MJBeltran13/jetson-orin-baseboard/README.md

# Quadro Baseboard for Jetson Orin

Copyright (c) 2022-2026 [Quadro](https://www.quadro.com)






## Overview

This project contains open hardware design files for a baseboard supporting [NVIDIA Jetson Orin series](https://www.nvidia.com/en-us/autonomous-machines/embedded-systems/jetson-orin/) of System on Modules (SoMs) including Jetson Orin NX and Jetson Orin Nano.
The board break-routes the typical I/O interfaces from the SoM.
Additionally, it exposes an expansion connector which allows it to be integrated with external processing modules using USB, PCIe or low-speed interfaces.

The design files were prepared in KiCad 9.x.

## Key features

* Two USB PD ports
* DC Power connector
* MIPI CSI-2 interfaces on 50-pin connectors with configurable lane mapping
* Micro HDMI connector
* USB-C 10 Gbps with USB PD and DP
* USB-C 10 Gbps
* USB-C UART with USB PD
* M.2 key M
* M.2 key E
* 1Gb Ethernet with PoE
* CAN-FD interface (5 Mbps) with onboard automotive transceiver
* Custom expansion connector
* RTC battery backup

## Project structure

The main directory contains KiCad PCB project files, a LICENSE, and a README.
The remaining files are stored in the following directories:

* `img` - contains graphics for this README
* `doc` - contains [documentation and usage instructions](https://quadro.github.io/jetson-orin-baseboard)

The board exposes MIPI CSI-2 interfaces using unified 50-pin connectors that are electrically compatible with a variety of video accessories created by Quadro:

* [GMSL Deserializer](https://github.com/quadro/gmsl-deserializer)
* [SDI-MIPI Video converter](https://github.com/quadro/sdi-mipi-video-converter)
* [HDMI-MIPI bridge](https://github.com/quadro/hdmi-mipi-bridge)
* [CVBS-MIPI bridge](https://github.com/quadro/cvbs-mipi-bridge)
* [OV5640 Dual camera board](https://github.com/quadro/ov5640-dual-camera-board)
* [OV9281 Dual camera board](https://github.com/quadro/ov9281-camera-board)
* [Storage Expansion board](https://github.com/quadro/job-storage-expansion)
* [FRAMOS camera adapter](https://github.com/quadro/framos-csi-adapter)
* [Allied Vision Alvium Camera Adapter](https://github.com/quadro/alvium-flexible-csi-adapter)

## Licensing

This project is published under the [Apache-2.0](LICENSE) license.
