MJBeltran13/jetson-orin-baseboard/output/feasibility/Quadro_1_Year_Precommercialization_Proposal.docx

| Reference No.: BatStateU-FO-RES-02 | | Effectivity Date: August 22, 2023 | | Revision No.: 04

DETAILED RESEARCH PROPOSAL

I. Research Project Title: Pre-Commercialization Development and Validation of Quadro Hardware and a Custom Linux OS for AI and Linux Learning (12 Months)

II. BatStateU Research Agenda: Industry, Energy and Emerging Technology Research (IEETR)

III. Sustainable Development Goal:
☐ SDG1: No Poverty | | | | ☐ SDG10: Reduced Inequalities
☐ SDG2: Zero Hunger | | | | ☐ SDG11: Sustainable Cities & Communities
☐ SDG3: Good Health & Well-being | | | | ☐ SDG12: Responsible Consumption & Production
☐ SDG4: Quality Education | | | | ☐ SDG13: Climate Action
☐ SDG5: Gender Equality | | | | ☐ SDG14: Life Below Water
☐ SDG6: Clean Water & Sanitation | | | | ☐ SDG15: Life on Land
☐ SDG7: Affordable and Clean Energy | | | | ☐ SDG16: Peace, Justice, & Strong Institutions
☐ SDG8: Decent Work & Economic Growth | | | | ☐ SDG17: Partnerships for the Goals
☐ SDG9: Industry, Innovation, & Infrastructure

IV. Project Leader: ____________________________________

Email Address: ____________________________________

Contact Number: ____________________________________

Project Staff: ____________________________________

Email Address: ____________________________________

V. Proponent Agency: Batangas State University

Department: STEER Hub

College: College of Engineering

Campus: Central

VI. Cooperating Agency: ____________________________________

Partner institutions will be identified through the pilot and market-validation activities.

VII. Executive Brief:

Quadro is a proposed educational computer combining a custom carrier board, a production NVIDIA Jetson Orin Nano 8 GB module and Quadro Learning OS. The 12 month project will develop and validate a maintained Linux image, guided AI and Linux lessons, recovery tools and instructor materials for Philippine educational institutions.

The existing repository supplies carrier design files and a reference Yocto BSP. It also records unresolved repair and qualification work. The proposed learning OS and educational outcomes have not yet been validated; release depends on engineering tests, classroom pilots and verified customer budgets. [1][2][3]

The 12 month version focuses on 10 engineering kits, three research cohorts, at least 30 learners and 10 instructors, and a documented commercial readiness decision.

The provisional project expenditure is PHP 2,900,000, excluding commercial inventory and paid-workshop delivery. Funding sources and eligible cost categories remain subject to institutional review. Commercial forecasts are conditional scenarios, rather than research outputs or assured sales.

VIII. Rationale:

AI education benefits from opportunities to prepare data, run models, examine errors and deploy applications. Linux competence also requires practical work with files, permissions, packages, networking, services and recovery. A dedicated learning device can connect these activities within one reproducible environment, provided the hardware and lessons remain reliable and usable.

Quadro will initially serve college and technical training laboratories with a clear edge AI use case. Schools can use existing PCs for many introductory Linux activities; the project must therefore demonstrate the added value of GPU-assisted deployment, physical interfaces and a supported classroom image. Affordability and willingness to buy will be investigated rather than assumed.

The first configuration will include an Orin Nano 8 GB production module, Quadro carrier, 128 GB NVMe storage, suitable power, active cooling and an enclosure. Displays, keyboards, mice and optional cameras are outside the base kit. The learning image will expose the normal Linux terminal and administration tools while adding lessons, notebooks and a documented recovery process.

The repository reference uses Yocto and JetPack 6.1. An Ubuntu-based learner image is proposed, with a carrier-specific migration and test plan. NVIDIA lists Orin support in JetPack 7.2.1; that support does not establish compatibility with the current Quadro board. Device tree, boot configuration, flashing and peripheral checks are required. [2][5][6]

The project will produce one validated hardware configuration, one versioned learning image, a 40 hour introductory course with 12 practical labs, a learner workbook, a teacher guide and a commercial readiness package. A proprietary cloud service or new LMS is outside the initial scope. Software, models and teaching materials will be distributed only under applicable licences. [11]

IX. Objectives of the Project:

The general objective is to establish the technical, educational, operational and commercial feasibility of Quadro as an AI and Linux learning platform within 12 months.

Specifically, the project aims to:

1. Repair and qualify 10 engineering kits, closing release-blocking design and manufacturing issues before classroom deployment.

2. Develop and test a custom Linux learning image, secure account setup, recovery procedure, 40 hour course and 12 practical labs.

3. Conduct three research cohorts with at least 30 learners and 10 instructors, using pre/post skills assessments, observation and structured feedback.

4. Validate institutional requirements through 20 buyer interviews, supplier quotations, a priced bill of materials and pilot agreements.

5. Prepare a business model, supply-chain workflow, compliance plan and evidence-based decision on controlled commercialization by month 12.

X. Expected Output of the Project:

1. Ten (10) engineering kits with serialised qualification records, a released design revision and a priced bill of materials.

2. One (1) tested Quadro Learning OS image, installation and recovery package, release manifest and account-security guide.

3. One (1) 40 hour course with twelve (12) labs, a learner workbook and a teacher reference guide covering Linux foundations, administration, Python, AI inference and a final project.

4. Three (3) research pilot cohorts, at least thirty (30) learner participants and ten (10) instructor participants.

5. One (1) iteration report after each cohort, with assessment summaries, usability findings, support effort and resulting changes.

6. One (1) business model, cost and price table, supply-chain map, support plan, compliance checklist and commercial release roadmap.

7. At least two (2) written pilot agreements and two (2) potential institutional or distribution channels investigated. No signed commercial partnership is assumed.

8. One (1) final technical and educational validation report and one (1) manuscript prepared for submission. Publication acceptance is outside the project team's control.

Proposed educational success criteria
Target at least 80 percent core-lab completion, 70 percent final-project completion and a median 20 percentage point improvement on the same skills rubric. Record unsuccessful attempts and withdrawals. These are proposed targets, not measured outcomes.

Social and economic impact
The intended social benefit is improved access to practical AI deployment and Linux skills through reusable teaching materials and locally supported equipment. The intended economic benefit is a tested route to assembly, training and support services. Adoption, employment and spin-off formation are possible outcomes to assess, rather than guaranteed impacts.

XI. Review of Related Literature:

1. What Has Been Done
Freeman et al. analysed 225 undergraduate STEM studies and reported better performance under active learning than traditional lecturing. This supports guided practice, problem solving and feedback in the proposed course. The study does not isolate ownership of a device or establish the effectiveness of Quadro, Linux instruction or AI training. [8]

Ouyang and Xu examined educational robotics across STEM settings and reported a positive overall effect, with variation across outcomes. Robotics differs from Quadro's AI and Linux focus. Their results support investigating a physical learning platform together with instructional design; they do not justify attributing gains to hardware alone. [9]

2. What Is Currently Being Done
NVIDIA provides Jetson educational resources and an ecosystem for hands-on AI projects. Its current Jetson software includes Orin support, while custom carrier deployment still requires adaptation and validation. These resources establish an available technical foundation rather than evidence of Quadro classroom success. [5][6][7]

The Linux Foundation's introductory course covers graphical and command-line work, applications and system configuration. It provides a curriculum benchmark and an optional learner resource. Free access does not establish permission to copy the course into Quadro materials. [10]

3. What We Are Proposing
Quadro will combine a qualified carrier board, a maintained learning image and assessed Linux and AI activities. Its contribution to investigate is whether this combination reduces teacher setup effort and supports completion of practical tasks in local classrooms. The study will document setup time, recovery effort, completion, assessed skill change and support demand.

The pilot will use pre/post assessment and qualitative feedback. Without random assignment or a comparison group, the results will support feasibility and iteration decisions, rather than a causal claim that Quadro outperforms other teaching methods. Local purchase demand and cost will be tested separately.

XII. Methodology:

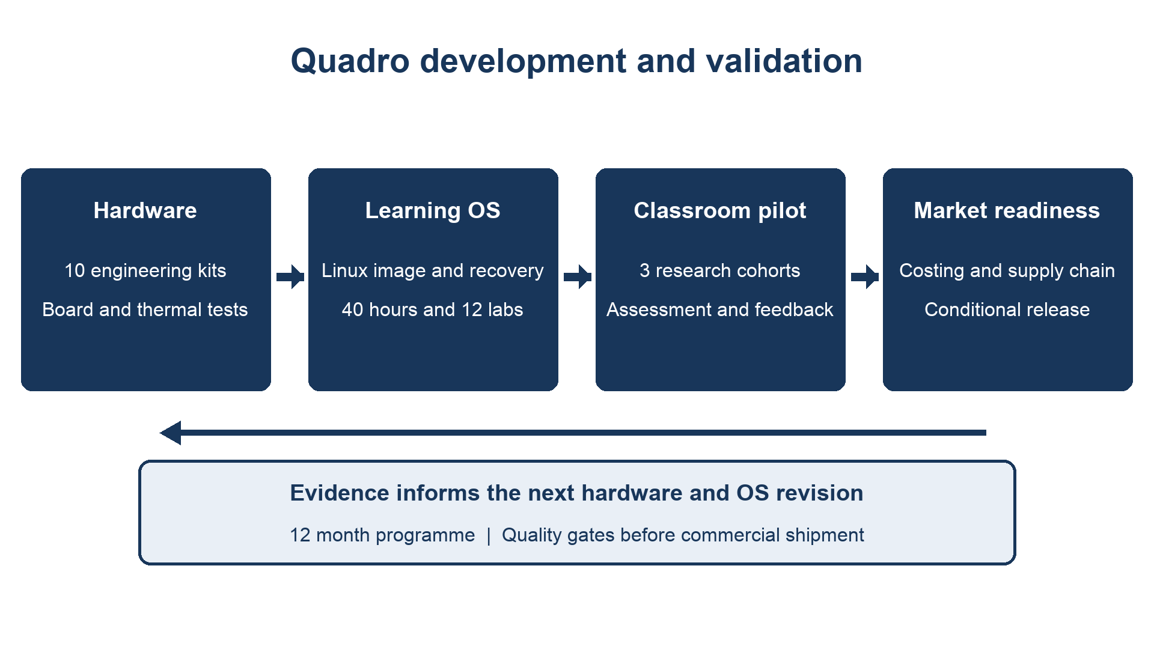
[picture p1: figure]
Quadro hardware, learning OS, classroom validation and commercial readiness process

Phase I Platform and demand definition Months 1 to 3
Interview 10 instructors, five lab managers and five procurement or budget staff. Record target learners, existing facilities, intended AI use cases, acceptable total cost and purchasing dates. Seek two pilot agreements without describing interest as a sale.

Review the current repair plan, complete a costed BOM and obtain assembly and landed-module quotations. Select one hardware revision and learner OS baseline. Demonstrate desktop operation, GPU libraries, storage, Ethernet and recovery on the target board by month 3 or revise the schedule. [3][6]

Phase II Engineering and learning package Months 3 to 6
Build and qualify 10 engineering kits. Proposed tests include 20 cold boots per kit and an eight hour mixed CPU, GPU and storage workload without a crash or thermal shutdown. Resolve release blockers, check accessible interfaces and record test conditions. These tests supplement, rather than replace, safety and compliance review.

Develop the learning image, first-boot credentials, student accounts, lesson launcher, Python notebooks and recovery instructions. Create 12 labs across Linux foundations, administration, AI inference and a small transfer-learning exercise. Large-model training is outside the introductory scope. Validate every included AI model on the final image.

Phase III Research pilots and revision Months 5 to 12
Conduct three cohorts with at least 30 learners and 10 instructors in total. Record voluntary participation, obtain required institutional and ethics permissions, and use anonymised identifiers. Educational participation will not depend on consenting to research data collection.

Use the same task rubric before and after instruction. Collect completion records, teacher setup time, recovery effort, support tickets, surveys and focused discussions. Analyse scores, paired changes, completion rates and qualitative themes descriptively; report sample size, withdrawals and limitations. Keep personal data access restricted and follow institutional retention rules.

Prepare an iteration report after each cohort. Re-test affected hardware or OS functions before further use. Research cohorts use engineering kits; paid customer workshops and saleable kits are separate enterprise activities and are not charged again to the pilot budget.

Commercial feasibility and release decisions
Use a proposed net kit price of PHP 49,000 and an illustrative 12 percent VAT-inclusive price of PHP 54,880 for willingness-to-pay testing. All price, volume, exchange and cost values remain assumptions until supported by quotations and orders. Production modules, rather than development kits, underpin the saleable product. [4]

The conditional enterprise scenario is 100 kits and six paid workshops in year 1. It produces a PHP 1.310 million result loss before tax, depreciation and financing.

Do not commit to the first 50 saleable kits until qualified prototypes, written manufacturing acceptance, a costed BOM at or below PHP 36,000 per kit, and at least 30 units of funded orders are in place. Confirm product-specific safety, EMC, radio, licence and data requirements before public sale. Each commercial unit requires a documented functional test.

XIII. Duties and Responsibilities of Each Member:

Project Leader and Project Operations
Coordinate deliverables, budget, research permissions, partner discussions and release decisions. Maintain the risk register and distinguish research funding from enterprise cash. Review prototype evidence, cohort findings and procurement commitments before authorising each stage.

Linux and BSP Engineer
Adapt the carrier configuration, build and version the learning image, maintain GPU and package compatibility, implement account and update security, and test recovery. Keep reproducible build instructions and an inventory of software and model licences.

Hardware and Manufacturing Engineer
Close schematic, PCB and manufacturing release blockers; manage prototype spins, power and thermal checks, assembly instructions and serialised production tests. Obtain supplier quotations and document design and BOM changes.

Curriculum and Validation Specialist
Prepare the 40 hour course, 12 labs, learner workbook and teacher guide. Design the rubric, facilitate research cohorts, analyse results and document revisions. Ensure pilot participation and data handling follow institutional requirements.

Staffing and accountability
The budget uses fractional role allocations, not four confirmed full-time appointments. Named assignments, qualifications, employment terms and institutional approvals must be completed before engagement. Extra specialist work requires an approved budget revision.

XIV. Major Activities and Work Plan:

See included Form A for the 12 month quarterly work plan and evidence required to proceed.

XV. Line Item Budget:

See included Form B. Proposed project expenditure totals PHP 2,900,000. Funding-source allocation and eligible classifications require institutional and funder approval. Commercial inventory and paid-workshop delivery are excluded from this project-cost total.
Personnel Services provisional classification | | PHP 1,440,000
Maintenance and Operating Expenses | | PHP 1,260,000
Capital Outlay and Equipment | | PHP 200,000
Total Proposed Project Cost | | PHP 2,900,000

XVI. References:

[1] Quadro. Jetson Orin Baseboard README and Apache 2.0 licence. Repository README.md, lines 12 to 31 and 54 to 56; LICENSE, sections 4 and 6.

[2] Quadro. Getting started and reference BSP. Repository doc/source/getting_started.md, lines 12 to 60, 133 to 151 and 324 onward.

[3] Quadro. PCB Repair Implementation Plan. Repository doc/PCB_REPAIR_PLAN.md, baseline dated 14 October 2026 and release gates. This is a recorded baseline, not fresh qualification.

[4] NVIDIA. Jetson FAQ. Production module guidance and suggested volume pricing; accessed 20 October 2026. Source (https://developer.nvidia.com/embedded/faq)

[5] NVIDIA. JetPack 7.2.1 with Jetson Linux 39.2.1. Orin support and Ubuntu 24.04 baseline; accessed 20 October 2026. Source (https://developer.nvidia.com/embedded/jetpack/downloads/archive-7.2.1)

[6] NVIDIA. Jetson Orin NX and Nano Series Adaptation and Bring Up. Carrier configuration and custom root filesystems; accessed 20 October 2026. Source (https://docs.nvidia.com/jetson/archives/r39.2.1/DeveloperGuide/HR/JetsonModuleAdaptationAndBringUp/JetsonOrinNxNanoSeries.html)

[7] NVIDIA. Jetson AI Education. Curriculum and project resources; accessed 20 October 2026. Source (https://developer.nvidia.com/embedded/learn/jetson-ai-education)

[8] Freeman, S., Eddy, S. L., McDonough, M., Smith, M. K., Okoroafor, N., Jordt, H., and Wenderoth, M. P. (2014). Active learning increases student performance in science, engineering, and mathematics. PNAS, 111(23), 8410-8415. DOI 10.1073/pnas.1319030111. Source (https://doi.org/10.1073/pnas.1319030111)

[9] Ouyang, F., and Xu, W. (2024). The effects of educational robotics in STEM education: A multilevel meta-analysis. International Journal of STEM Education, 11, Article 7. DOI 10.1186/s40594-024-00469-4. Source (https://doi.org/10.1186/s40594-024-00469-4)

[10] The Linux Foundation. Introduction to Linux LFS101. Course description; accessed 20 October 2026. Source (https://training.linuxfoundation.org/training/introduction-to-linux/)

[11] NVIDIA. Jetson Linux 39.2.1 Software License Agreement. Redistribution conditions and component licence terms; accessed 20 October 2026. Source (https://developer.download.nvidia.com/embedded/L4T/r39_Release_v2.1/release/Tegra_Software_License_Agreement-Tegra-Linux.txt)

XVII. Curriculum Vitae: See included Form C completion sheet. Attach the signed CV of each designated researcher and specialist before formal submission.

*Required Attachment (use appropriate ISO Form): (A) Major Activities and Work Plan; (B) Line-item Budget; (C) Curriculum Vitae

Prepared by: ________________________________ ________________________________ Project Leader Date Signed: | | | | Department: STEER Hub
| | | | College: College of Engineering / Integrated School
| | | | Campus: Central

Pursuant to Republic Act No. 10173, also known as the Data Privacy Act of 2012, the Batangas State University, the National Engineering University recognizes its commitment to protect and respect the privacy of its customers and/or stakeholders and ensure that all information collected from them are all processed in accordance with the principles of transparency, legitimate purpose and proportionality mandated under the Data Privacy Act of 2012.

To be accomplished by the Research Office
Checklist: ☐ Complete Documents Detailed Proposal LIB Work Plan ☐ Initial Screening Form Score: _______ | | | | Level of Call ☐ Central Agency (VPRDES, President) ☐ Constituent Campus (VCRDES, Chancellor)

To be accomplished by the Researcher/s
Checked and Verified by: ____________________________ ________________________________ Director, Research Date Signed: | | | | Recommending Approval: ____________________________ ________________________________ Vice President for Development and Extension Services Date Signed:

Approved by the Research Council Represented by:

_______________________________

________________________________

University President/

Date Signed:

Notes: The Signatories funded by:

Approval through Research Council

Director, Research; Vice President for RDES: & University President

Approval through Local Research Evaluation Committee

Head, Research/Head Research & Extension; Vice Chancellor for RDES; & Vice President for RDES

| Reference No.: BatStateU-FO-RES-02 | | Effectivity Date: August 22, 2023 | | Revision No.: 04

FORM A MAJOR ACTIVITIES AND WORK PLAN

Project: Quadro Hardware and Custom Linux OS for AI and Linux Learning | Duration: 12 months

Each quarter covers three months from project commencement. X indicates planned activity; release depends on the evidence listed.

Activity | Q1 | Q2 | Q3 | Q4 | Output
Buyer interviews and pilot agreements | X | | | | 20 interviews and 2 pilot agreements
Carrier repair and engineering kits | X | X | | | 10 kits with qualification records
Learning OS build and recovery | X | X | X | X | Tested image and recovery package
Course workbook and teacher guide | X | X | X | X | 40 hours and 12 labs
First 3 research cohorts and revision | | X | X | X | 30 learners and 10 instructors
BOM costing and supply chain | X | X | X | X | Quotes cost model and manufacturing workflow
Commercial readiness assessment | | | X | X | Conditional launch decision

Responsibilities: Project Leader coordinates delivery and approvals; Linux Engineer owns the OS; Hardware Engineer owns board and manufacturing evidence; Curriculum Specialist owns learning materials and pilot assessment.

Gate 1 by month 3: demonstrate the target learner image and identify buyer budgets. Gate 2 by month 6: close release blockers and qualify prototypes. Gate 3 before commercial build: confirm compliance, costed BOM, manufacturing acceptance, funded orders and cash availability.

| Reference No.: BatStateU-FO-RES-02 | | Effectivity Date: August 22, 2023 | | Revision No.: 04

FORM B LINE ITEM BUDGET

Quadro 12 month project | Currency PHP | Provisional expenditure before final institutional classification

Budget line | Basis | Amount PHP
Linux and BSP engineering | 45,000 monthly x 12 | 540,000
Hardware and manufacturing engineering | 35,000 monthly x 12 | 420,000
Curriculum and validation | 25,000 monthly x 12 | 300,000
Project and customer operations | 15,000 monthly x 12 | 180,000
Personnel subtotal | Fractional role allocations | 1,440,000
Facilities administration sales and support | 30,000 monthly x 12 | 360,000
Engineering kits and board spins | 10 engineering kits and revision allowance | 480,000
OS release work | External work beyond team allocation | 100,000
Research pilot activities | Separate from paid workshops | 80,000
External validation and compliance | Scope and quotations to confirm | 140,000
Production setup and instructions | External setup allowance | 100,000
MOOE subtotal | Subject to eligibility review | 1,260,000
Test and recovery equipment | Equipment allowance | 200,000
Total proposed project expenditure | Excludes enterprise trading costs | 2,900,000

Personnel amounts are planning allocations; the institution will determine whether an item is personnel services or contracted services. Sales, warranty and enterprise support may require counterpart funding. No allowance is confirmed eligible for a grant. Final funding sources and counterpart shares remain for approval.

No double counting: the engineering kits and board spins are in development expenditure. Saleable kits are enterprise inventory. Paid customer-workshop delivery is separate from the research pilot allowance. Team labour is separate from the listed external work.

Separate commercial scenario: year 1 inventory purchases PHP 3,600,000 and paid-workshop variable costs PHP 60,000; these are outside the PHP 2,900,000 project-cost total.

The enterprise base case has PHP 5,050,000 revenue and a PHP 1,310,000 result loss before tax, depreciation and financing. Its conservative cash-funding envelope is PHP 6,810,000.

Cash envelopes include project and trading flows, no deposits, two-month hardware collections, prepaid batches and a 20 percent reserve on the cash trough. They are not grant budgets and must not be added to the project-cost total. Tax timing, bad debts and financing require a separate cash review.

All figures are estimates rather than quotations. The PHP 27,000 year 1 landed module target assumes PHP 60 per USD and additions to NVIDIA's USD 399 suggested 1000-unit price. Small-volume pricing must be quoted. [4]

| Reference No.: BatStateU-FO-RES-02 | | Effectivity Date: August 22, 2023 | | Revision No.: 04

FORM C CURRICULUM VITAE COMPLETION SHEET

Complete one signed institutional CV for each designated member. This sheet records the information required; it does not state credentials or confirm appointment.

Required information | To be completed by the named person
Full name | ____________________________________________
Proposed project role | ____________________________________________
Institution department and position | ____________________________________________
Email and contact number | ____________________________________________
Highest degree field institution and year | ____________________________________________ ____________________________________________
Relevant hardware Linux AI or teaching experience | ____________________________________________ ____________________________________________ ____________________________________________
Relevant projects and responsibilities | ____________________________________________ ____________________________________________ ____________________________________________
Selected publications or technical outputs | ____________________________________________ ____________________________________________
Professional registration or training if relevant | ____________________________________________ ____________________________________________
Proposed time allocation and availability | ____________________________________________
Signature and date | ____________________________________________

Attach supporting and signed CVs using the institution's current prescribed format before submission. Approval names, signatures and dates in the proposal remain blank until completed by the authorised individuals.

Tracking No.________________ Page of
