MJBeltran13/jetson-orin-baseboard/output/feasibility/Quadro_Feasibility_Study_1_Year_Philippines.docx

# Quadro feasibility study 1 year

Philippines | AI and Linux learning hardware

12 month pilot and launch plan | 20 October 2026

# Executive decision

Proceed with a funded pilot only. A 12 month programme can test Quadro hardware, its educational Linux image and school demand. The base case does not recover development or operating costs within the year. Commercial shipments depend on successful board qualification and funded orders.

Quadro is a proposed learning computer built around a custom carrier board and a production NVIDIA Jetson Orin Nano 8 GB module. Quadro Learning OS is the proposed name for a maintained Linux distribution with lessons, AI tools and recovery support. It is a product to develop, rather than an established educational OS.

Decision metric | Base case assumption
Planning horizon | 12 months
Hardware sales target | 100 kits
Price per kit excluding VAT | PHP 49,000
Illustrated price including 12 percent VAT | PHP 54,880
Revenue | PHP 5.050 million
Result before tax depreciation and financing | PHP 1.310 million loss
Planning funding envelope | PHP 6.810 million

All financial figures are scenario estimates, not supplier quotations or confirmed demand. The funding envelope includes a 20 percent reserve on the conservative cash trough. Tax cash timing and finance costs require an additional review.

## Evidence that changes the decision

The repository documents an existing Orin carrier design and a reference Yocto BSP. Its 14 October 2026 repair plan also records unresolved design and release work. Historical board releases do not qualify the current revision for classroom sale. Fresh engineering checks and bench evidence are required. [1][2][3]

This study treats months as time from funding approval. Year 1 is identical in both versions, allowing a direct comparison. The intended readers are Quadro founders, education partners and prospective funders.

# Product and technical feasibility

## A focused first product

Launch one configuration: Orin Nano 8 GB production module, Quadro carrier, 128 GB NVMe, suitable power supply, active cooling, protective enclosure and preinstalled learning image. Include a recovery guide, teacher notes and basic hardware support. Schools supply displays, keyboards, mice and network access. Cameras, robotics kits and Wi-Fi are optional and outside the base costing.

The README lists camera, USB, HDMI, M.2, Ethernet and expansion interfaces. Validate each interface included in the sale specification on the exact board revision. Do not promise every documented interface or a high power mode before testing. [1][3]

## Build the learning OS on supported Linux

The repository reference is a Yocto system based on JetPack 6.1. NVIDIA now lists JetPack 7.2.1 with Orin support and an Ubuntu 24.04 baseline. These are different software baselines; migration and carrier compatibility need explicit testing. [2][5]

Use an Ubuntu based Jetson image as the preferred learner environment. Reuse verified carrier configuration where compatible. NVIDIA requires carrier-specific device tree, boot configuration and flashing work. By month 3, demonstrate the desktop, GPU libraries, storage, Ethernet and recovery on the target board; otherwise replan the launch. A Yocto reference image remains useful for hardware diagnosis. [6]

Add Quadro lesson packages, a desktop lesson launcher, Python notebooks and reproducible environments. Keep the terminal and normal Linux administration tools available. Use standard package and image tooling. Provide unique first-boot credentials, student accounts, signed release manifests, tested updates and a documented reflash procedure.

## Learning scope and evidence

Learning strand | Practical activity | Proposed evidence
Linux foundations | Files, permissions, shell, processes and packages | Learner completes tasks without a script
Linux administration | SSH, networking, logs, services and recovery | Learner diagnoses a prepared fault
AI foundations | Python, data splits, evaluation and model limits | Notebook explains accuracy and errors
Applied AI | Run image inference and a small transfer learning lab | Saved output and reproducible benchmark
Final project | Package an AI application as a Linux service | Working demonstration and short report

Plan a 40 hour introductory course with 12 practical labs. AI inference and small educational training exercises fit the intended scope. Large model training needs other compute. Measure each supported model on the final image; memory use, latency and thermal results determine what enters the curriculum. NVIDIA resources can inform lessons, subject to their terms. [7]

# Market and commercial feasibility

Prioritise Philippine colleges, universities, technical training providers and senior secondary STEM programmes that need hands-on AI deployment. The likely buyer is a lab manager or department, while teachers and students use the product. Individual hobbyists are a secondary channel because the proposed kit price is substantial.

The value proposition is a complete classroom experience: a working Linux image, practical AI lessons, teacher preparation and local hardware support. Hardware capability alone does not prove schools will pay the proposed price. Market feasibility remains conditional on interviews and paid pilot orders.

## Compare the complete learning experience

Alternative | Strength for the buyer | Implication for Quadro
Existing PCs with Linux or virtual machines | Reuses equipment for Linux and basic Python lessons | Quadro needs a clear edge AI and physical hardware use case
Raspberry Pi based systems | Broad maker ecosystem and general Linux access | Compete on tested curriculum and supported AI workflows
NVIDIA developer kit | Direct access to the NVIDIA software ecosystem | Compare complete local cost and support; use kits for development [4]
Quadro learning kit | Proposed integrated image, lessons and local support | Must prove reliability, teacher value and total cost

## Validate willingness to buy

During months 1 to 3, interview 10 instructors, five lab managers and five procurement or budget staff. Test the PHP 54,880 illustrated kit price, required accessories, lead times and support expectations. Secure two written pilot agreements and identify the budget owner. Treat expressions of interest separately from purchase orders.

Run three pilot cohorts involving at least 30 learners using 10 engineering kits. These kits sit in development expenditure and are separate from saleable inventory. Proposed success targets are 80 percent completion of core labs, 70 percent completion of the final project, and a median 20 percentage point improvement on the same skills rubric. Record instructor setup time and support tickets. These are targets, not measured results.

## Sales targets and channel

The base case assumes five institutional orders averaging 20 kits, producing 100 kit sales. Build a pipeline of at least 20 qualified institutional opportunities by month 4. Qualification means an identified teacher, budget owner, intended class and procurement window. The assumed conversion rate requires validation.

Sell directly to institutions through demonstrations, teacher workshops and small lab deployments. The model assumes six paid workshops in year 1. Each workshop costs the institution PHP 25,000 excluding VAT. No subscription or grant income is included.

A 10 kit lab costs PHP 548,800 at the illustrated VAT-inclusive price, before displays and other accessories. A workshop adds PHP 28,000 if the same VAT treatment applies. Compare this complete purchase with a school using existing PCs before committing to hardware volume.

# Operations staffing and compliance

Use a small founder-led team and contract PCB assembly. The figures below represent monthly role allocations, not verified market salaries or four full-time positions. Increase the budget if full-time recruitment, statutory employment costs or specialist work cannot fit these allowances.

Role or expense | Monthly PHP
Linux and BSP engineering | 45,000
Hardware and manufacturing | 35,000
Curriculum and teaching | 25,000
Project and customer operations | 15,000
Team allocation total | 120,000
Facilities sales administration and warranty support | 30,000
Recurring monthly cost | 150,000

## Release and manufacturing workflow

Freeze one schematic, PCB revision and priced bill of materials. Resolve release-blocking ERC, DRC and schematic parity issues; document justified exceptions. Obtain independent design review, assembler feedback and product-specific compliance advice before ordering the sale batch. The recorded repair plan is the starting gate, not proof of a pass. [3]

Qualify 10 prototypes under the intended power profile. Check power sequencing, accessible I/O safety, cooling, enclosure fit and repeatable flashing. Proposed acceptance targets include 20 cold boots per prototype and an eight hour mixed CPU, GPU and storage run without a crash or thermal shutdown. Test every sold unit for boot, storage, network, display and the supported AI lesson. Keep serial numbers, test logs and image versions.

Maintain a recovery workstation, replacement stock and a return process. Aim to acknowledge support requests within two business days. Offer a proposed 12 month limited hardware warranty with terms reviewed for Philippine consumer obligations. Warranty repair and routine support are budgeted in recurring overhead; they are not extra revenue.

## Compliance before public sale

Register the business and obtain applicable local permits, tax registration and invoicing arrangements. Use an accountant to confirm VAT treatment, import duties and credit timing. Consult an accredited adviser on product safety, EMC and whether any included radio configuration requires NTC approval. Omitting Wi-Fi from the base kit reduces initial scope but does not establish a blanket exemption. [10][11]

Keep student data on the device by default. Provide a privacy notice and retention rules before collecting learner records or images; use anonymised teaching datasets. The Data Privacy Act applies to personal-data handling. Audit software, dataset and model licences before distribution. Preserve upstream notices and review Quadro trademark rights independently. [1][8][9][12]

# Financial assumptions and projected results

All amounts are PHP and exclude VAT unless stated. This is an illustrative management model. Revenue, procurement costs and timing require confirmation before investment. No grants, recurring subscriptions or unpaid founder labour are counted as income or hidden cost savings.

NVIDIA lists the production Orin Nano 8 GB at USD 399 for 1000 or more units. That is not a quote for this plan. An assumed PHP 60 per USD produces PHP 23,940 before local landed additions; the model targets PHP 27,000 landed in year 1. Obtain an actual small-volume quotation. Production modules and developer kits are different purchases. [4]

Cost per saleable kit | PHP
Production module landed | 27,000
Carrier PCB components and assembly | 4,000
128 GB NVMe storage | 1,600
Power cooling and enclosure | 2,000
Final assembly and functional test | 600
Packaging and fulfillment | 800
Total variable cost per kit | 36,000

The base price is PHP 49,000 net, or PHP 54,880 with an illustrative 12 percent VAT. Unit contribution is PHP 13,000 in year 1. The gross hardware margin is 26.5 percent. Workshops contribute PHP 15,000 each after PHP 10,000 of variable delivery cost. [11]

Year 1 metric | PHP or units
Kits sold | 100
Hardware revenue | 4,900,000
Workshop revenue | 150,000
Total revenue | 5,050,000
Variable costs | 3,660,000
Contribution | 1,390,000
Recurring fixed costs | 1,800,000
One time development expense | 900,000
Result before tax depreciation financing | -1,310,000
Equipment capex outside result | 200,000

Year 1 development comprises PHP 480,000 for prototype units and board spins, PHP 100,000 for OS release work, PHP 80,000 for pilots, PHP 140,000 for external validation and compliance, and PHP 100,000 for production setup. These are external allowances beyond team labour.

Development is expensed for this decision model. Equipment is shown separately as a cash purchase; depreciation, income tax, financing and owner distributions are excluded. Recoverable VAT is excluded from costs. Nonrecoverable taxes must be added when known.

# Cash needs break even and sensitivity

The cash model assumes no deposits and hardware collection two months after shipment. Workshop fees are collected in the delivery month. Unit costs are paid in full when a batch is built. All monthly outflows precede receipts when calculating the conservative trough. Opening cash is zero before financing.

Year 1 ships 10, 10, 15, 15, 20 and 30 kits in months 7 to 12. It prepays 50 kits in month 6 and 50 in month 10. Supply lead times must fit these delivery dates; earlier deposits increase the funding need.

Period | Net cash PHP m | Cumulative PHP m
Months 1 to 3 | -1.150 | -1.150
Months 4 to 6 | -2.650 | -3.800
Months 7 to 9 | 0.085 | -3.715
Months 10 to 12 | -0.245 | -3.960

The conservative peak cash deficit is PHP 5.675 million in month 10. Adding 20 percent gives a planning funding envelope of PHP 6.810 million. The month-end-only peak is lower at PHP 5.160 million. These are funding requirements, not operating expenses.

At month 12, cash before financing is negative PHP 3.960 million. Closing trade receivables are PHP 2.450 million and saleable inventory is zero in the base case. VAT remittances, withheld taxes, bad debts and finance costs can increase cash needs. The reserve is not a substitute for a tax cash schedule.

## Break even and downside exposure

With six workshops, 132 kit sales cover recurring fixed costs. Including development requires 201 kits, above the 100 kit target. Formula: round up (fixed costs + applicable development - workshop contribution) / kit contribution.

Year 1 scenario | Annual result PHP
70 kits | -1,700,000
100 kits base case | -1,310,000
150 kits | -660,000
100 kits and 10 percent price reduction | -1,800,000

A 12 month launch is therefore a validation investment. It needs funding independent of first-year profit. Reduce batch sizes or negotiate deposits to release cash; confirm customers accept the terms before changing the model.

# Implementation milestones and decision gates

Months | Work | Evidence to proceed
1 to 2 | Interviews and design repair | Price tested with buyers; repair scope and quotes accepted
3 to 4 | Prototype and OS validation | Target board boots learner image; critical interfaces pass
5 to 6 | Classroom pilot and release | Learning targets reviewed; compliance and manufacturing gates closed
7 to 9 | First commercial deliveries | First 35 kits shipped; support and payment data tracked
10 to 12 | Second batch and evaluation | 100 kits total if funded orders exist; decide year 2 investment

## Risks that can stop the plan

Risk | Assessment | Response and owner
Current board fails qualification | High impact; likelihood unmeasured | Hardware lead closes release blockers before sale
Schools reject price or delay payment | High impact; demand unproven | Commercial lead validates budgets and funded orders
Module cost or availability changes | High impact; quote absent | Operations lead obtains landed quotes and lead times
OS migration or recovery fails | High impact; work remains | Linux lead proves target image and recovery by month 3
Support or compliance exceeds budget | High impact; allowance unquoted | Project lead recosts before each production commitment

## Release funding only against evidence

- Approve the first three months for customer discovery and engineering proof. Delay large inventory commitments until the technical and purchasing gates pass.
- Before the initial 50 kit batch, require at least 30 units of funded orders, a costed BOM at or below PHP 36,000 per kit, qualified prototypes and written manufacturing acceptance.
- Require paid pilot evidence that learners complete the course and teachers can recover devices. A letter of interest alone does not establish demand.
- If the carrier or learning image fails its gate by month 6, pause custom-hardware sales. Continue educational testing on development systems only after revising the budget and schedule.

Recommendation: the one year plan is conditionally feasible as a funded pilot and limited launch. It is not financially self-sustaining at the base volume. Proceed only if the founders accept the planned loss and can finance the cash cycle.

# Sources and basis of estimates

External sources were checked on 20 October 2026. Bracketed source numbers in the study refer to the entries below. Repository statements describe documentation and recorded plans, rather than fresh electrical certification.

[1] Quadro project README and Apache 2.0 license. Repository README.md, lines 12 to 31 and 54 to 56; LICENSE, sections 4 and 6. Hardware intent and redistribution terms.

[2] Quadro reference BSP and hardware requirements. Repository doc/source/getting_started.md, lines 12 to 60, 133 to 151 and 324 onward. Reference software, kit requirements and account setup.

[3] Quadro PCB repair implementation plan. Repository doc/PCB_REPAIR_PLAN.md, baseline dated 14 October 2026 and release gates at lines 138 to 153. Historical record; refresh before fabrication.

[4] NVIDIA Jetson FAQ (https://developer.nvidia.com/embedded/faq). Production module distinction and official suggested USD pricing. Module prices apply at 1000 or more units.

[5] NVIDIA JetPack 7.2.1 release (https://developer.nvidia.com/embedded/jetpack/downloads/archive-7.2.1). Orin family support and Ubuntu 24.04 baseline with Jetson Linux 39.2.1.

[6] NVIDIA Orin adaptation guide (https://docs.nvidia.com/jetson/archives/r39.2.1/DeveloperGuide/HR/JetsonModuleAdaptationAndBringUp/JetsonOrinNxNanoSeries.html). Carrier configuration, device tree, flashing and custom root filesystems.

[7] NVIDIA Jetson AI education (https://developer.nvidia.com/embedded/learn/jetson-ai-education). Hands-on educational resources; these do not establish Quadro learning outcomes.

[8] NVIDIA release specific software license (https://developer.download.nvidia.com/embedded/L4T/r39_Release_v2.1/release/Tegra_Software_License_Agreement-Tegra-Linux.txt). Redistribution conditions and separate component licenses for Jetson Linux 39.2.1.

[9] National Privacy Commission (https://privacy.gov.ph/the-data-privacy-act-and-its-irr/). Data Privacy Act and implementing rules.

[10] National Telecommunications Commission Region 7 (https://region7.ntc.gov.ph/faqs/). Equipment approval guidance; obtain product-specific applicability advice.

[11] Bureau of Internal Revenue ruling ITAD-027-25 (https://bir-cdn.bir.gov.ph/BIR/pdf/BIR%20Ruling%20No.%20ITAD-027-25.pdf). General 12 percent VAT rule in the cited ruling. Actual registration, credits and timing require tax review.

[12] IPOPHL trademark search tools (https://www.ipophil.gov.ph/trademark/trademark-online-tools/). Search resources for brand clearance; no Quadro clearance is implied.

## Assumptions that need validation

The study does not estimate a national market size or claim completed customer research. Sales volumes, school conversion, staffing allocations, supplier costs, exchange rate, learning outcomes, collection terms and cost reductions are planning assumptions. No purchase commitments or investment returns are guaranteed.

The first year in both versions uses the same 100 kit and six workshop scenario. Prototype units are funded through development expenditure. Production units generate variable costs. Equipment purchases are separate from development and recurring costs. A current priced BOM, payroll plan, tax cash schedule and monthly supplier terms must replace allowances before a commercial funding decision.

Electrical verification, physical performance tests, trademark clearance, legal opinions and supplier quotations remain required launch work. The product must pass these checks before the team commits to commercial shipment.

Quadro | 1 year feasibility study |
